cbiffle/keybrain/v1.jpg

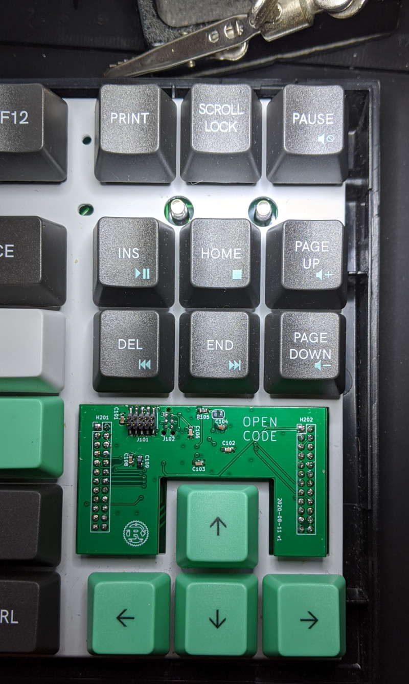
v1.jpg
