cbiffle/keybrain/wasd-code-upgrade.kicad_pcb

## KiCad design wasd-code-upgrade.kicad_pcb (2020-08-21)

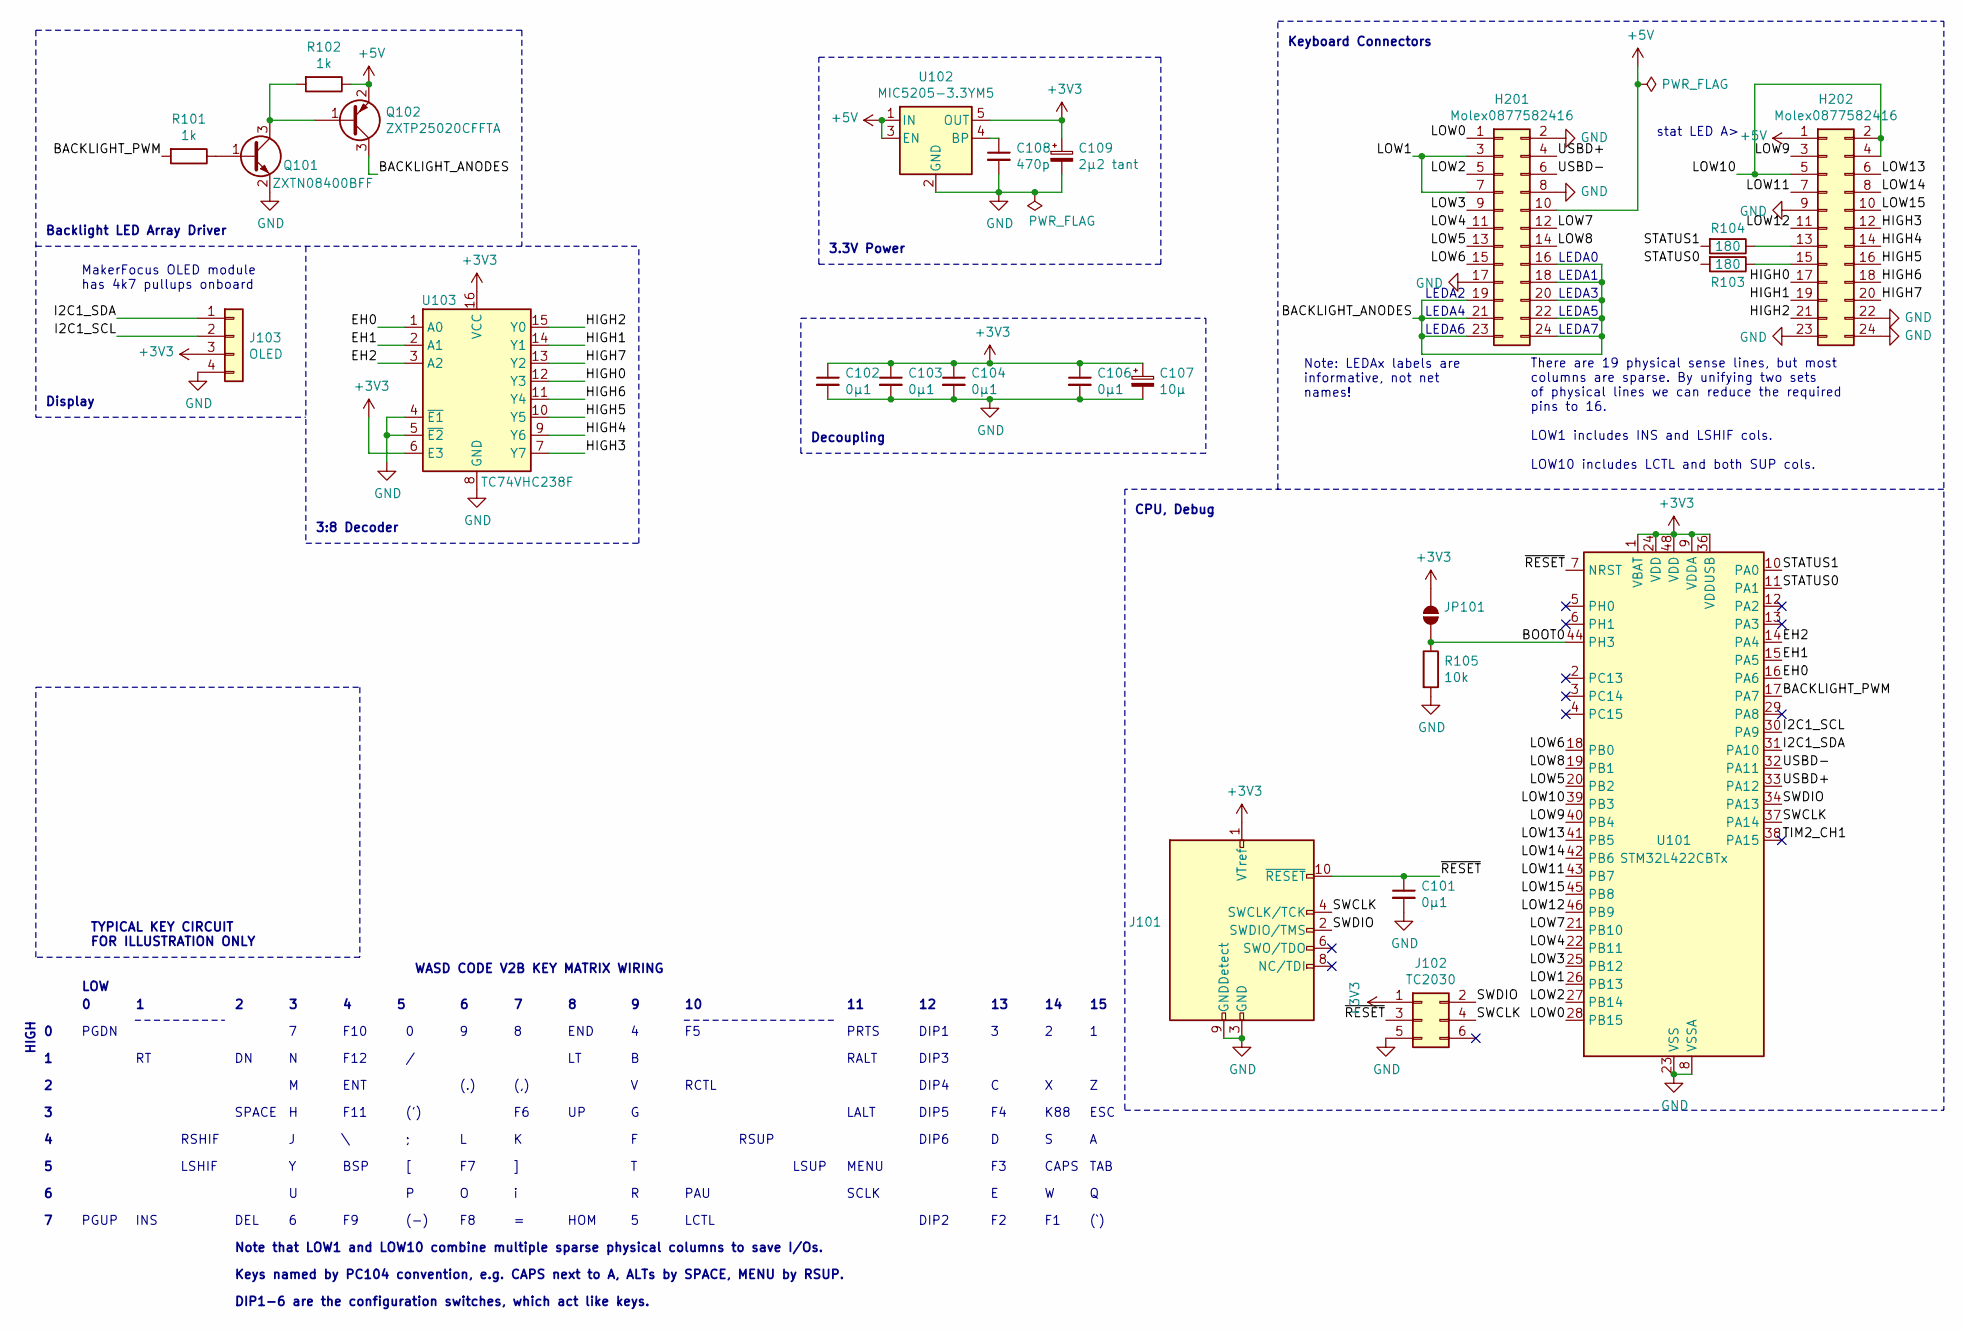
[picture p2: schematic wasd-code-upgrade.kicad_sch, WASD CODE v2B Replacement Controller]

Parts:
C101, C102, C103, C104, C106: 0µ1; C_0603_1608Metric
C107: 10µ; C_0603_1608Metric
C108: 470p; C_0603_1608Metric
C109: 2µ2 tant; C_0603_1608Metric
H201, H202: Molex0877582416; PinHeader_2x12_P2.00mm_Vertical
J101: Conn_ARM_JTAG_SWD_10; PinHeader_2x05_P1.27mm_Vertical_SMD
J102: TC2030; Tag-Connect_TC2030-IDC-NL_2x03_P1.27mm_Vertical
J103: OLED; PinSocket_1x04_P2.54mm_Vertical_SMD_Pin1Left
JP101: SolderJumper_2_Open; SolderJumper-2_P1.3mm_Open_RoundedPad1.0x1.5mm
Q101: ZXTN08400BFF; SOT-23
Q102: ZXTP25020CFFTA; SOT-23
R101, R102: 1k; R_0603_1608Metric
R103, R104: 180; R_0603_1608Metric
R105: 10k; R_0603_1608Metric
U101: STM32L422CBTx; LQFP-48_7x7mm_P0.5mm
U102: MIC5205-3.3YM5; SOT-23-5
U103: TC74VHC238F; VSSOP-16_3.0x4.25mm_P0.5mm

Connections:
+3V3: C102.1, C103.1, C104.1, C106.1, C107.1, C109.1, J101.1 (VTref), J102.1, J103.3, JP101.1 (A), U101.1 (VBAT), U101.9 (VDDA), U101.24 (VDD), U101.36 (VDDUSB), U101.48 (VDD), U102.5 (OUT), U103.6 (E3), U103.16 (VCC)
+5V: H201.10, H202.1, Q102.2 (E), R102.1, U102.1 (IN), U102.3 (EN)
/BACKLIGHT_ANODES: H201.16, H201.18, H201.19, H201.20, H201.21, H201.22, H201.23, H201.24, Q102.3 (C)
/BACKLIGHT_PWM: R101.2, U101.17 (PA7)
/BOOT0: JP101.2 (B), R105.1, U101.44 (PH3)
/EH0: U101.16 (PA6), U103.1 (A0)
/EH1: U101.15 (PA5), U103.2 (A1)
/EH2: U101.14 (PA4), U103.3 (A2)
/HIGH0: H202.17, U103.12 (Y3)
/HIGH1: H202.19, U103.14 (Y1)
/HIGH2: H202.21, U103.15 (Y0)
/HIGH3: H202.12, U103.7 (Y7)
/HIGH4: H202.14, U103.9 (Y6)
/HIGH5: H202.16, U103.10 (Y5)
/HIGH6: H202.18, U103.11 (Y4)
/HIGH7: H202.20, U103.13 (Y2)
/I2C1_SCL: J103.2, U101.30 (PA9)
/I2C1_SDA: J103.1, U101.31 (PA10)
/LOW0: H201.1, U101.28 (PB15)
/LOW1: H201.3, H201.7, U101.26 (PB13)
/LOW2: H201.5, U101.27 (PB14)
/LOW3: H201.9, U101.25 (PB12)
/LOW4: H201.11, U101.22 (PB11)
/LOW5: H201.13, U101.20 (PB2)
/LOW6: H201.15, U101.18 (PB0)
/LOW7: H201.12, U101.21 (PB10)
/LOW8: H201.14, U101.19 (PB1)
/LOW9: H202.3, U101.40 (PB4)
/LOW10: H202.2, H202.4, H202.5, U101.39 (PB3)
/LOW11: H202.7, U101.43 (PB7)
/LOW12: H202.11, U101.46 (PB9)
/LOW13: H202.6, U101.41 (PB5)
/LOW14: H202.8, U101.42 (PB6)
/LOW15: H202.10, U101.45 (PB8)
/STATUS0: R103.2, U101.11 (PA1)
/STATUS1: R104.2, U101.10 (PA0)
/SWCLK: J101.4 (SWCLK/TCK), J102.4, U101.37 (PA14)
/SWDIO: J101.2 (SWDIO/TMS), J102.2, U101.34 (PA13)
/TIM2_CH1: U101.38 (PA15)
/USBD+: H201.4, U101.33 (PA12)
/USBD-: H201.6, U101.32 (PA11)
/~RESET: C101.1, J101.10 (~RESET), J102.3, U101.7 (NRST)
GND: C101.2, C102.2, C103.2, C104.2, C106.2, C107.2, C108.2, C109.2, H201.2, H201.8, H201.17, H202.9, H202.22, H202.23, H202.24, J101.3 (GND), J101.5 (GND), J101.9 (GNDDetect), J102.5, J103.4, Q101.2 (E), R105.2, U101.8 (VSSA), U101.23 (VSS), U101.35 (VSS), U101.47 (VSS), U102.2 (GND), U103.4 (~E1), U103.5 (~E2), U103.8 (GND)
unnamed: C108.1, U102.4 (BP)
unnamed: H202.13, R104.1
unnamed: H202.15, R103.1
unnamed: Q101.1 (B), R101.1
unnamed: Q101.3 (C), Q102.1 (B), R102.2

Notes on the sheet:
LEDA6
(-)
LCTL
LALT
(,)
END
INS
DIP6
LEDA0
DIP2
LEDA2
Keys named by PC104 convention, e.g. CAPS next to A, ALTs by SPACE, MENU by RSUP.
Note that LOW1 and LOW10 combine multiple sparse physical columns to save I/Os.
DIP3
(`)
DIP1-6 are the configuration switches, which act like keys.
(')
RSHIF
LSHIF
LEDA7
DIP5
RCTL
SCLK
DEL
K88
PRTS
Backlight LED Array Driver
3.3V Power
LEDA3
CAPS
WASD CODE V2B KEY MATRIX WIRING
TAB
TYPICAL KEY CIRCUIT FOR ILLUSTRATION ONLY
Display
LEDA4
PAU
LEDA1
F11
There are 19 physical sense lines, but most columns are sparse. By unifying two sets of physical lines we can reduce the required pins to 16. LOW1 includes INS and LSHIF cols. LOW10 includes LCTL and both SUP cols.
DIP1
HIGH
SPACE
LEDA5
RALT
Keyboard Connectors
PGDN
HOM
(.)
MakerFocus OLED module has 4k7 pullups onboard
stat LED A>
LOW
BSP
Note: LEDAx labels are informative, not net names!
CPU, Debug
F12
F10
RSUP
MENU
ENT
3:8 Decoder
Decoupling
DIP4
ESC
LSUP
PGUP

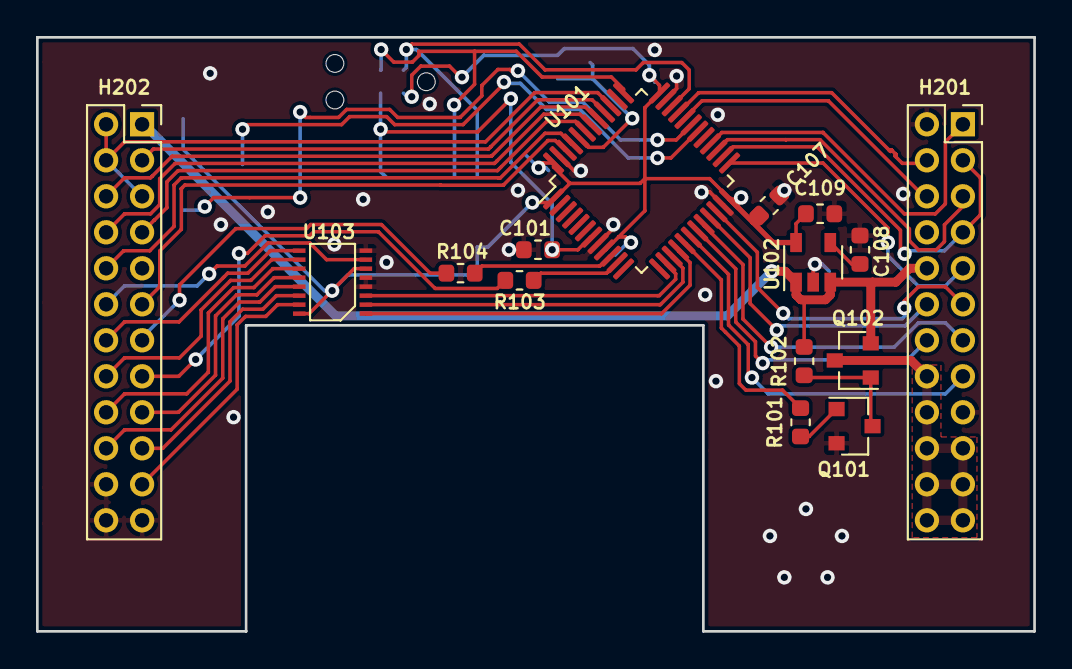
[picture p3: board wasd-code-upgrade.kicad_pcb from above]

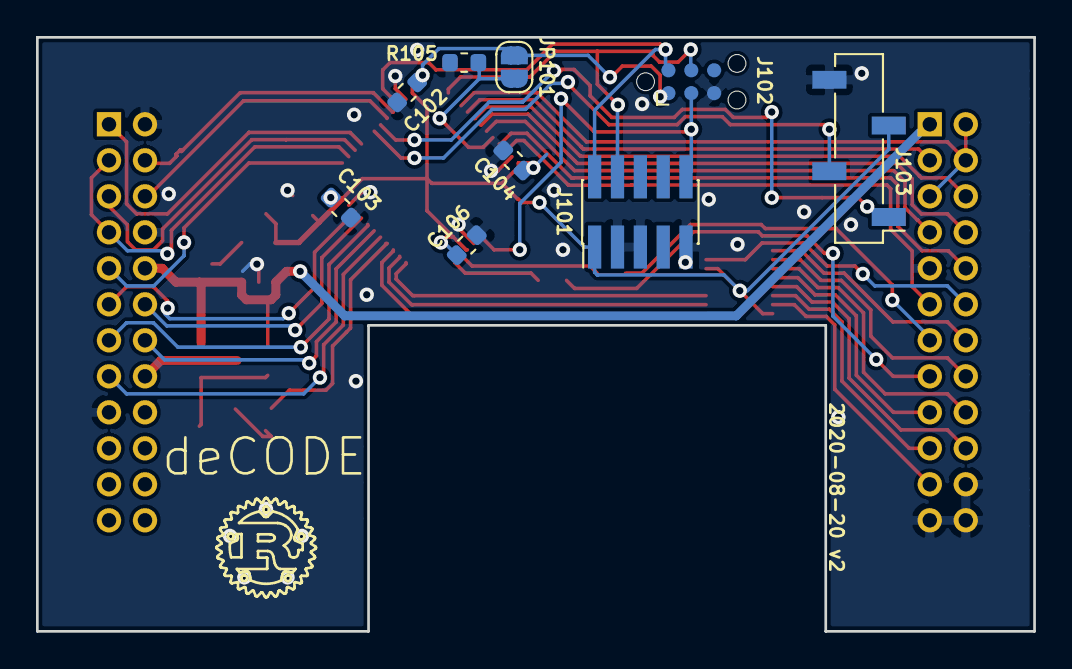
[picture p4: board wasd-code-upgrade.kicad_pcb from below]

Board: 2 copper layers, 55.4 x 33.0 mm, 24 parts (9 on the bottom side), 47 nets.
