cbiffle/keybrain/(commit log)

2020-08-04 fourk: forgot to commit pcb??
2020-08-09 fourk/fw: start factoring out USB driver
2020-08-09 fourk/fw: continue factoring out driver
2020-08-10 fourk/fw: scan matrix with DMA
2020-08-12 wasd-code-upgrade: schematic polish, matrix table
    [wasd-code-upgrade.sch]
2020-08-15 wasd-code-upgrade: v2 layout
    [wasd-code-upgrade.kicad_pcb, wasd-code-upgrade.sch]
2020-08-15 wasd-code-upgrade: high side decoder simplifies routing
    [wasd-code-upgrade.kicad_pcb, wasd-code-upgrade.sch]
2020-08-15 wasd-code-upgrade: socket for MakerFocus OLED
    [wasd-code-upgrade.kicad_pcb, wasd-code-upgrade.sch]
2020-08-15 wasd-code-upgrade: tidy schematic
    [wasd-code-upgrade.sch]
2020-08-21 wasd-code-upgrade: rework after playing with v1
    - Move _very bright_ status LEDs to PWM-capable pins.
    - Fix mistakes in matrix.
    - Simplify some layout to move more things to topside.
    [wasd-code-upgrade.kicad_pcb, wasd-code-upgrade.sch]
2020-08-22 fw: add feature for distinguishing v1/v2 boards
2020-08-22 fw: insert some barriers
2020-08-22 fw: slightly ugly LED support
2024-06-01 Update to Kicad 8.x
    [wasd-code-upgrade.kicad_sch, wasd-code-upgrade.sch]
